GarouxE/Arduino/README.md

Projet Arduino Air Hockey

Cahier de charges:

Presentation du projet:
Nous souaitons réaliser un Air-Hockey où les goals sont commandés à distance grâce à des mannettes de jeu. 
Les goals se deplaceront seulement sur la largeur du plateau de jeu grace à un rail.
De plus, les goals seront equipés d'un ressort pour propulser le palet, ce ressort sera activé par le joueur en appuyant sur un bouton.

Structure du projet en 2 parties:

            1/ Le Deplacement                               2/ La Propulsion
        - Construction du rail	                    - Comment activer le ressort 
        - Controler le moteur (prog)                    - Comment le brancher a l'arduino
        - Comment marche la manette                     - Construction du goal
        - Branchement de la manette                     - Comment marche le bouton
        - Relier manette/goal                           - Brancher le bouton a l'arduino
                                                        - Connecter bouton/ressort

Materiel nécéssaire:

          Plateau de jeu         30*50cm
          Moteur x2    (nema 17)           
          Bouton x2              
          Manette x2
          Rail x2               
            Support metallique
            Tige helicoidale
            Support
          Ressort x2            Solenoide ZYE1-0530Z
                A 1K resistor
                TIP120 transistor (TIP102 will also work fine)
                1N4004 diode (1N4001 also works)
                Some batteries and connectors for solenoid power
                A solenoid with leads to connect to the breadboard
          Des cables
          Cache cables x2

Planning des séances:

                                 Ewan                                         Pauline
  1 -(13/12)-          Construction du rail                          Comment activer le ressort
  2 -(20/12)-          Construction du rail/Controle moteur          Comment activer le bouton/Brancher à l'arduino
Pause pedagogique
  3 -(10/01)-           Controller Moteur                            Construction du goal/comment marche la manette
  4 -(17/01)-                                 Resoudre eventuels problemes        
  5 -(24/01)-                                 Mise en commun des codes
Pause pedagogique
  6 -(07/02)-           Comment marche le bouton/Branchement bouton  Comment marche la manette/Branchement manette   
  7 -(14/02)-           Tout relier ensemble                          Tout relier ensemble
  8 -(21/02)-           Correction de erreurs                         Correction de erreurs

Avancée du projet:

                  Partie	                                  Statut
        Propulseur de palais sur le goal	                Pas fait
        Bouton activation goal	                          Pas fait
        Déplacement du goal avec moteur sur rails	        Pas fait
        Contrôle déplacements avec manette	              Pas fait

Sources utiles:
  Construction rail https://www.instructables.com/DIY-IRONLESS-LINEAR-SERVO-MOTOR/
  Utilisation Solenoide https://www.makerguides.com/control-a-solenoid-with-arduino/
