GarouxE/Arduino/CompteRenduDeTP/TP8/Rapport_de_séance_8BAILET.pdf

BAILET
Pauline
G4
Rapport de séance 21/02/2024

Aujourd’hui nous avons continuer le montage du Air hockey, voici les différentes taches que j’ai pu effectuer :

- Collage des capteurs de fin de course sur les rails
- Découpe des 2 pièces de bois pour fixer le deuxième rail
- Réalisation de pièces support qui permettrons d’accrocher les rails sur le jeu
- Impression d’une pièce test sur laquelle l’arc de cercle était trop grand par rapport à celui du Air hockey, j’ai donc réduit le rayon puis imprimer les pièce de bonne taille.

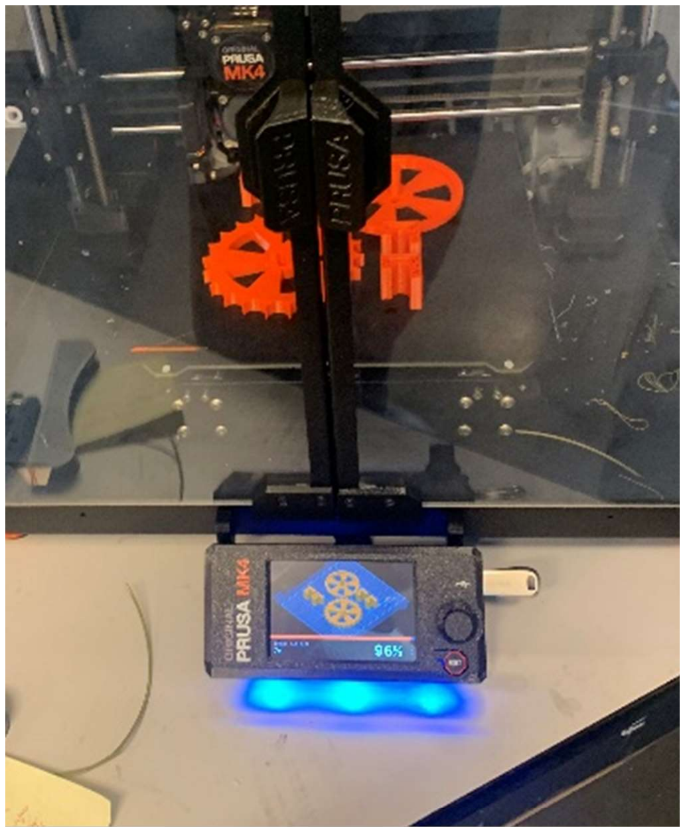
[picture p16: figure]
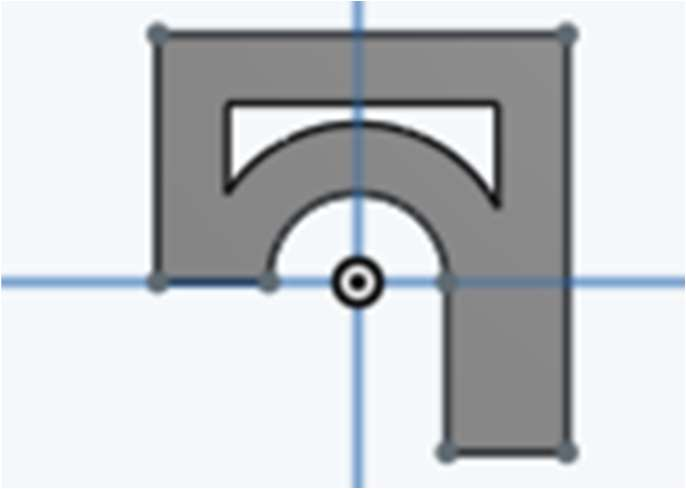
[picture p17: figure]

J’ai aussi modifié le code des boutons et le code du module Bluetooth pour y intégrer les capteurs de fin de course :

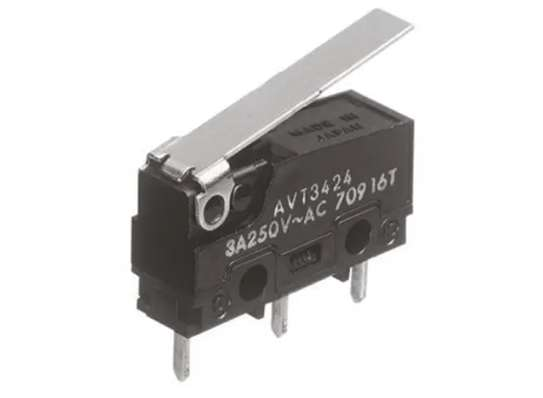
[picture p18: figure]

Les capteurs possèdent 3 bornes : NO, NC et S (reliée
avec l’Arduino).
Nous utilisons la borne Normalement Ouvert pour que lorsque les capteurs sont pressés, le rail arrête de bouger.

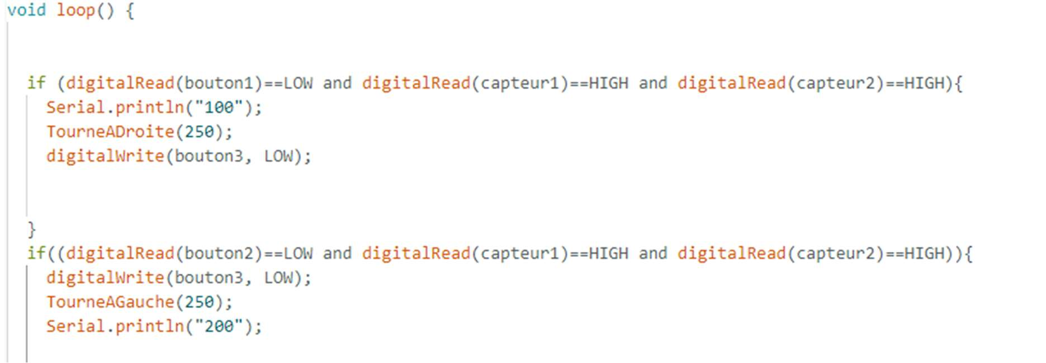
[picture p19: figure]

(Code coté boutons)

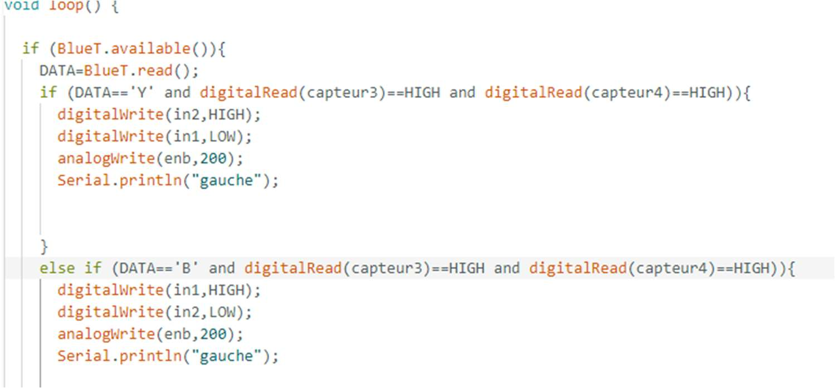
[picture p20: figure]

(Coté module Bluetooth)
