GarouxE/Arduino/CompteRenduDeTP/TP7/Rapport_de_seance_7BAILET.pdf

### BAILET Pauline

G4

## Rapport de séance 14/02/24

Cette séance nous avons commencé l’assemblage du projet.

J'ai imprimé puis collé les nouveaux goals sur les solénoïdes.

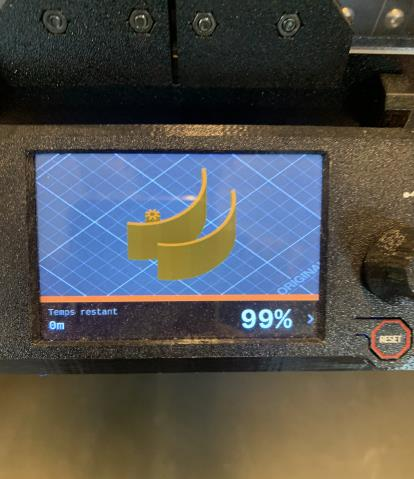
[picture p21: figure]
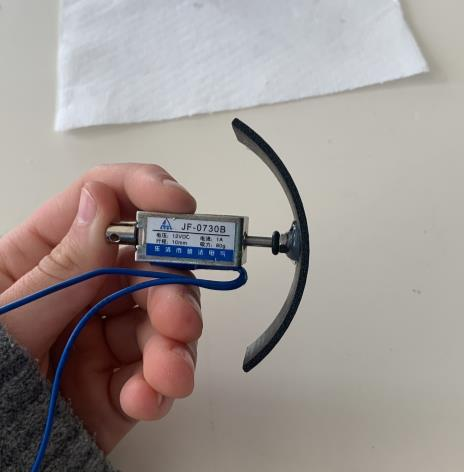
[picture p22: figure]

J’ai construit une boite sur CaseMaker puis téléchargé le plan 2D de chaque face pour pouvoir les passer à la découpe laser. Cette boite est destinée à cacher les carte Arduino/cerveau moteur/fils etc.

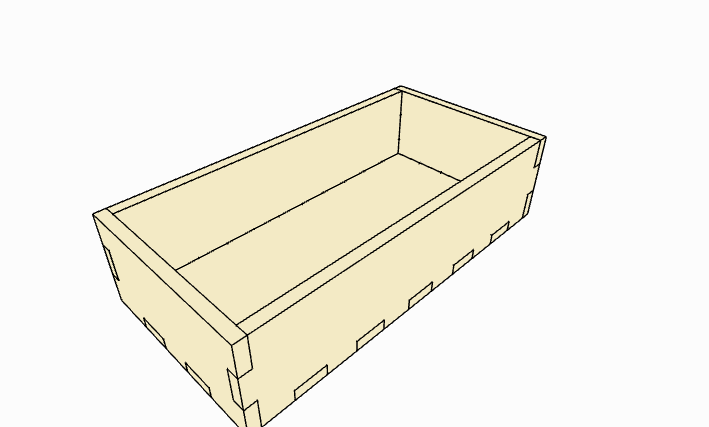
[picture p23: figure]
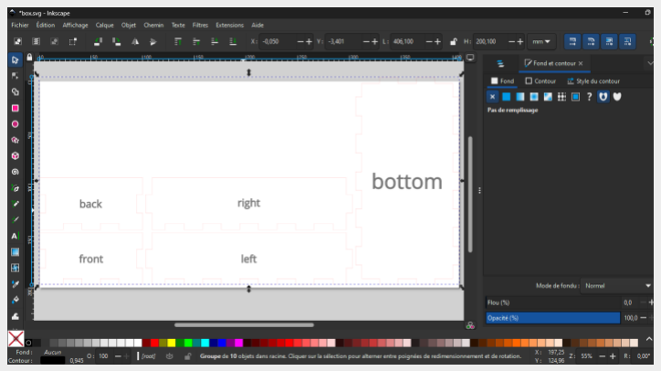
[picture p24: figure]

La découpe laser n’a pas été possible, Ewan a donc découpé des morceaux sur des chutes de bois que j’ai ensuite collés entre eux pour fabriquer la boite.

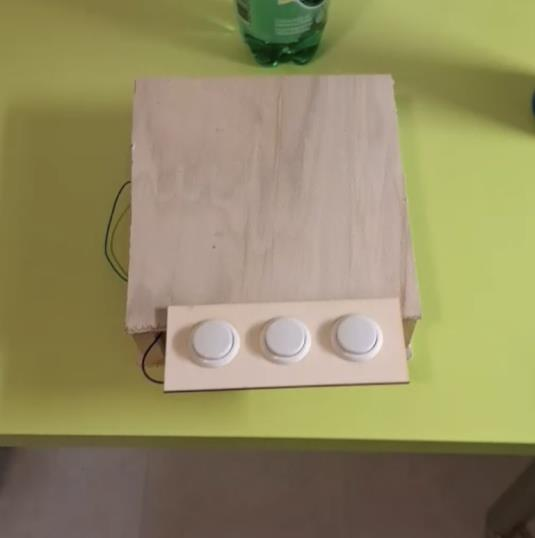
[picture p25: figure]
