GarouxE/Arduino/CompteRenduDeTP/TP6/Rapport-de-séance-6BAILET.pdf

### BAILET Pauline

G4

## Rapport de séance 07/02/24

Cette séance j’ai continué de travailler sur le module Bluetooth.

On a à présent un coté du jeu qui est entièrement contrôlé sur téléphone avec le code suivant :

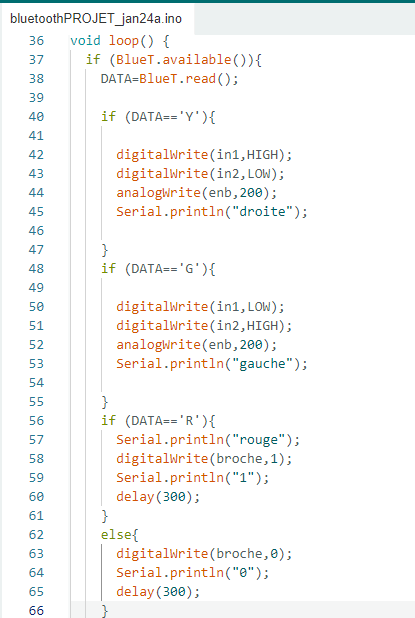
[picture p26: figure]
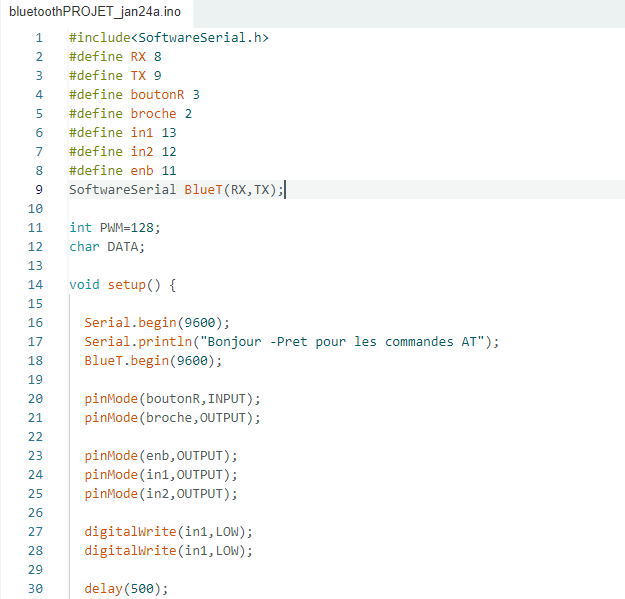
[picture p27: figure]

Nous avons changé l’alimentation du solénoïde car la précédente ne permettait pas au solénoïde de sortir en entier.

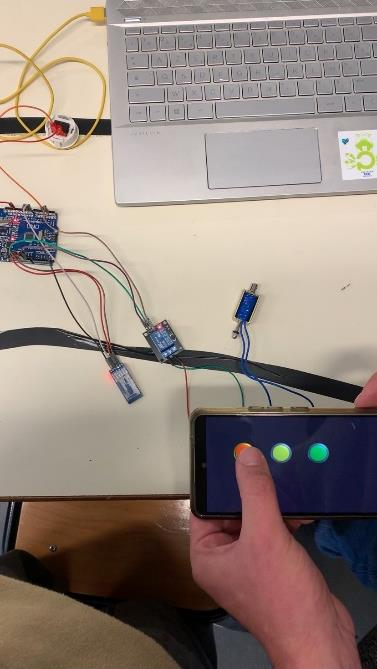
[picture p28: figure]

(Ewan appuie sur le bouton et le solénoïde est activé)

J’ai commencé une nouvelle modélisation du goal qui est plus propre que le goal actuel.

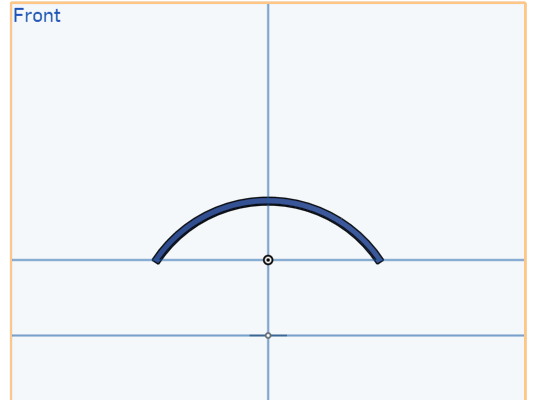
[picture p29: figure]

Avec Ewan, nous avons assemblé le rail et le moteur.

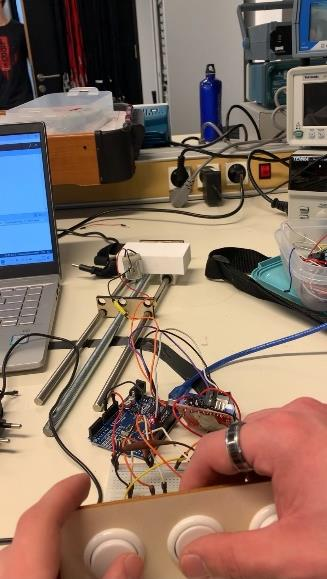
[picture p30: figure]

(Ewan appuie sur bouton droit et la partie blanche se déplace vers la droite).
