GarouxE/Arduino/CompteRenduDeTP/TP5/Rapport_de_séance_5BAILET.pdf

### BAILET Pauline

G4

## Rapport de séance 24/01/24

Cette séance était consacrée à mettre en commun nos codes et nos constructions.

Nous avons donc assemblé le solénoïde et le bouton avec le moteur et ses boutons directeurs.

Le code reste à améliorer.

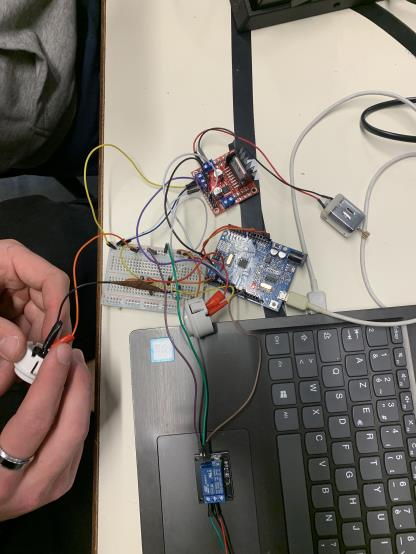
[picture p31: figure]

Comme j’ai fini ma partie sur le solénoïde/goal/bouton, nous avons revu notre planning et décidé de commander un des deux goals sur téléphone grâce à un module Bluetooth.

Je me suis donc servie du module HC-06 déjà vu en cours et j’ai commencé à écrire le code suivant.

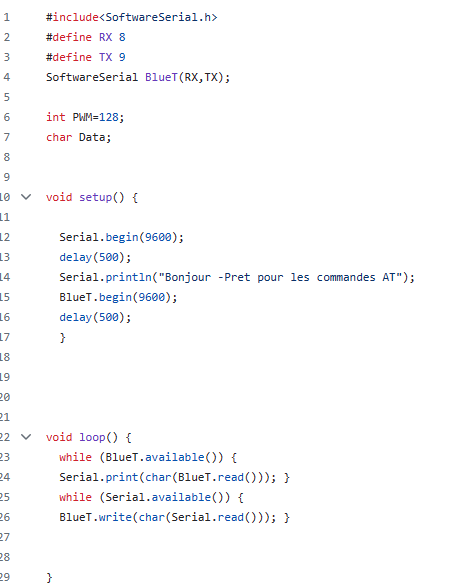
[picture p32: figure]

Le but sera donc de pouvoir commander les boutons pour activer le solénoïde, pour déplacer le goal à droite et à gauche sur téléphone.

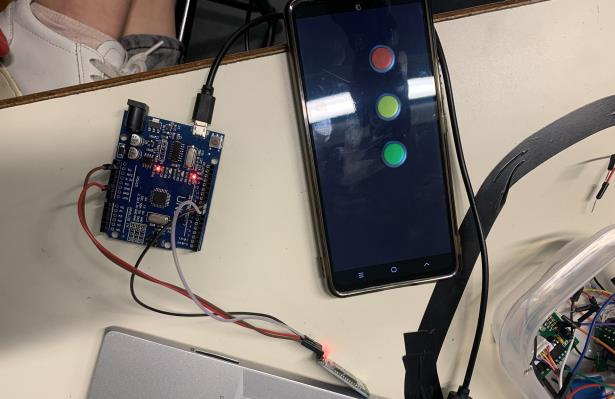
[picture p33: figure]

Une fois les pièces du rail terminées nous les avons assemblées.

Il ne reste plus qu’à fixer le solénoïde sur le goal puis le goal sur la partie blanche.

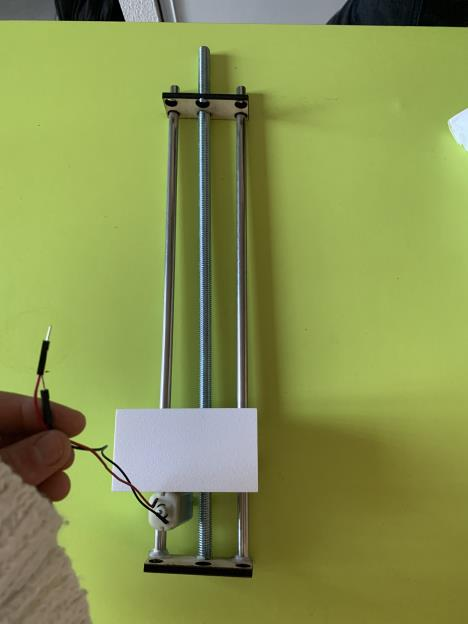
[picture p34: figure]
