GarouxE/Arduino/CompteRenduDeTP/TP4/Rapport_de_seance_4BAILET.pdf

BAILET
Pauline
G4

### Rapport de séance 17/01/24

Pendant cette séance nous avions planifié de régler tous les problèmes liés à nos premiers montages/constructions.

J’ai donc repris le code du solénoïde pour y ajouter une contrainte :

Le joueur ne peut pas appuyer plusieurs fois d’affilé sur le bouton activant le solénoïde. Je vais essayer de mettre une limite.

En codant je me suis rendu compte de l’effet rebond, c'est à dire qu'entre le moment où l'on appuie sur le bouton et qu'on le relâche, la carte qui agit beaucoup plus vite qu'un être humain, considère le bouton à plusieurs états à la fois ouvert et fermé.

Avec Ewan, nous avons donc chercher plusieurs solutions (condensateur antirebond, fonction debounce),

Mais la plus simple etait d’ajouter un delay après l’activation du bouton.

En plus, ce delay permet aussi de réaliser la contrainte voulue.

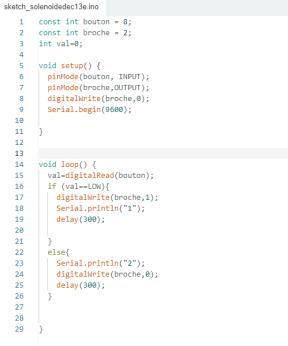
[picture p50: figure]

Une fois le code finit, il ne reste plus qu’à monter le tout sur le goal, j’ai pris une alimentation secteur, nous avons réalisé toutes les soudures nécessaires, il faut maintenant fixer le solénoïde sur le goal.

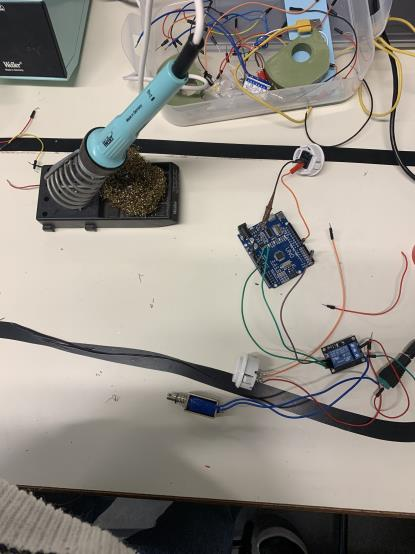
[picture p51: figure]
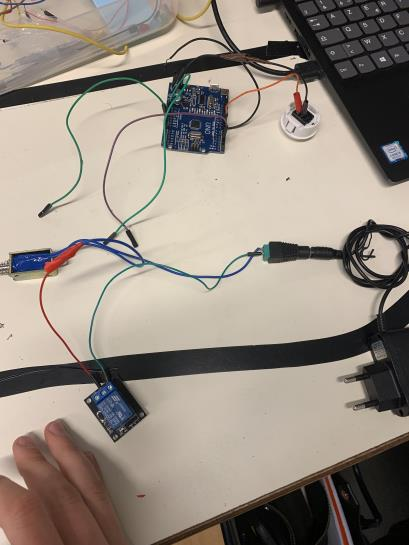
[picture p52: figure]
